carsten-walther/wortuhr/builds/faces/ines/plate/DE/Plate INES (de).pdf

NEUN ZEHN ELF ZWÖLF

ACHT SIEBEN SECHS FÜNF

EINS ZWEI DREI VIER

ZWANZIG NACH VOR HALB

FÜNF ZEHN VIERTEL

GENAU DREI-
