carsten-walther/wortuhr/builds/faces/maria/plate/DE/Plate MARIA (de).pdf

ZWÖLF

ZEHN

ACHT

SECHS

VIER

ZWEI

HALB

NACH

VIERTEL

DREI

ELF

NEUN

SIEBEN

FÜNF

DREI

EINS

VOR

ZEHN

ZWANZIG

FÜNF
