carsten-walther/wortuhr/builds/faces/nina/plate/DE/Plate NINA (de).pdf

EINS | ZWÖLF
ZEHN | SIEBEN | VIER
FÜNF ACHT | ZWEI DREI
SECHS | | NEUN
NACH VOR | HALB | ELF
FÜNF ZEHN | VIERTEL
ZWANZIG | DREI-
