carsten-walther/wortuhr/(commit log)

2026-08-19 feat: ESPHome word clock firmware for ESP32-C3
    German word clock driving 25 WS2811 LEDs behind an INES front plate. Runs
    ESPHome on an ESP32-C3 with a DS1307 for timekeeping and reports to Home
    Assistant over the native API and MQTT.
    - Four switchable dialects (Hochdeutsch, Bayrisch, Sächsisch, Schwäbisch)
    that differ only at the quarters
    - SNTP time written back to the battery-backed RTC on every sync, so the
    panel is right after a power cut with no network
    - esp-idf framework with esp32_rmt_led_strip, so strip timing comes from
    the RMT peripheral rather than from a bit-banged library
    - Encrypted API and MQTT in parallel, discovery off to avoid a duplicate
    set of entities in Home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
    [Grid.scad]
2026-08-19 feat: adopt boot handling, diagnostics and power settings from Infinity
    Aligns the word clock with its sibling config in the infinity project, which
    had already worked through several of these.
    Fixes:
    - The on_boot stage at priority 200 tested wifi.connected and could never be
    true: every on_boot trigger runs inside setup(), milliseconds apart, while
    the radio needs hundreds of milliseconds to associate. Replaced by a
    wifi: on_connect trigger. A BOOT_RAINBOW_TIMEOUT deadline ends the boot
    rainbow when there is no network to connect to, so the clock still shows the
    time offline from the DS1307. Both paths call one guarded script, so the
    second to arrive is a no-op and a later re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
    [wortuhr.yaml]
2026-08-19 fix: push boot-constant diagnostics instead of polling, drop dead on_shutdown
    Carries the findings from the infinity.yaml review back to this config. Config
    validates and the esp-idf build is green: RAM 35.4%, flash 68.4%, unchanged -
    these are cadence and comment changes, not code.
    - Reset Reason and Firmware Version were polled at 60s. Neither can change
    while the device is up: esp_reset_reason() latches the cause at reset and the
    version is a compile-time constant. publish_state does not deduplicate, so
    that was 2880 identical messages a day across the api and mqtt both. Both now
    carry an id and update_interval: never, and are pushed from the on_boot
    priority -100 block next to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
    [wortuhr.yaml]
2026-08-19 Use Twinkle as boot effect; rename timeout; add Wi-Fi
    Switch the boot/start-up effect from "Rainbow" to "Twinkle" across README and wortuhr.yaml, including the on_boot/on_connect flow and the script guard. Rename substitution BOOT_RAINBOW_TIMEOUT to BOOT_TIMEOUT and update its uses. Replace single wifi SSID/password with a networks list (home/work) and new secret names. Tweak docs for gamma_correct and effects, and reduce Twinkle progress_interval from 4ms to 2ms.
    [wortuhr.yaml]
